jorgeregidor/Motion_Capture/Eagle/Gerber/0x69-2.brd

## EAGLE design Eagle/Gerber/0x69-2.brd (2014-03-29)

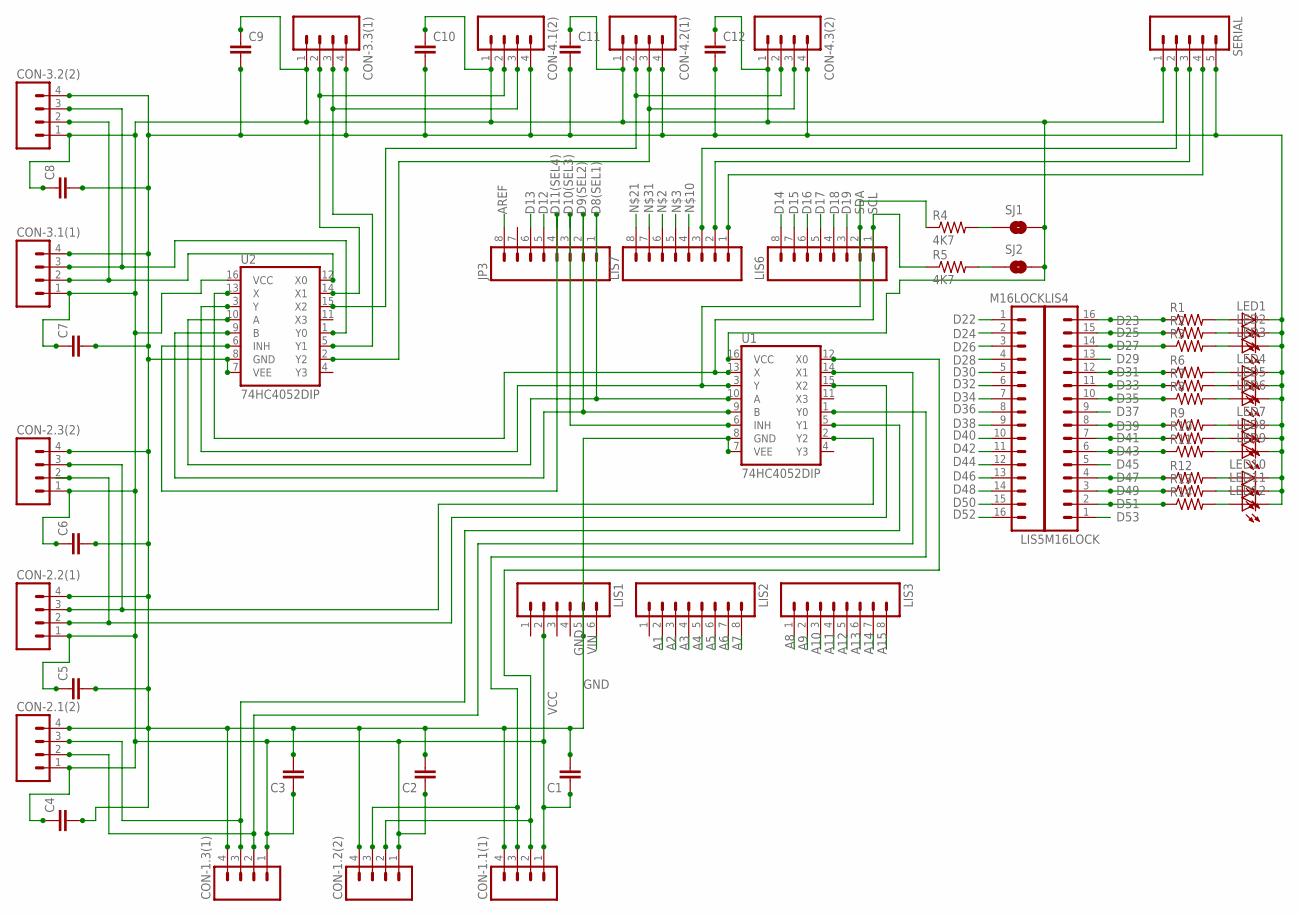
[picture p1: schematic 0x69-2.sch]

Parts:
C1, C2, C3, C4, C5, C6, C7, C8, C9, C10, C11, C12: C; C0805
CON-1.1(1), CON-1.2(2), CON-1.3(1), CON-2.1(2), CON-2.2(1), CON-2.3(2), CON-3.1(1), CON-3.2(2), CON-3.3(1), CON-4.1(2), CON-4.2(1), CON-4.3(2): M04LONGPADS; 1X04_LONGPADS
JP3: M08LOCK; 1X08_LOCK
LED1, LED2, LED3, LED4, LED5, LED6, LED7, LED8, LED9, LED10, LED11, LED12: LED-FKIT-1206; FKIT-LED-1206
LIS1: M06LOCK; 1X06_LOCK
LIS2, LIS3, LIS6, LIS7: M08LOCK; 1X08_LOCK
LIS4, LIS5: M16LOCK; 1X16_LOCK
R1, R2, R3, R6, R7, R8, R9, R10, R11, R12, R13, R14: 0.22OHM1/4W1%(0805); 0805
R4, R5: 4K7; 0603-RES
SERIAL: M05PTH_LONGPADS; 1X05_LONGPADS
SJ1, SJ2: SOLDERJUMPERNC; SJ-NC
U1, U2: 74HC4052DIP; DIL16

Connections:
A1: LIS2.2
A2: LIS2.3
A3: LIS2.4
A4: LIS2.5
A5: LIS2.6
A6: LIS2.7
A7: LIS2.8
A8: LIS3.1
A9: LIS3.2
A10: LIS3.3
A11: LIS3.4
A12: LIS3.5
A13: LIS3.6
A14: LIS3.7
A15: LIS3.8
AREF: JP3.8
D8(SEL1): JP3.1, U1.10 (A), U2.10 (A)
D9(SEL2): JP3.2, U1.9 (B), U2.9 (B)
D10(SEL3): JP3.3, U1.6 (INH)
D11(SEL4): JP3.4, U2.6 (INH)
D12: JP3.5
D13: JP3.6
D14: LIS6.8
D15: LIS6.7
D16: LIS6.6
D17: LIS6.5
D18: LIS6.4
D19: LIS6.3
D22: LIS5.1
D23: LIS4.16, R1.1
D24: LIS5.2
D25: LIS4.15, R2.1
D26: LIS5.3
D27: LIS4.14, R3.1
D28: LIS5.4
D29: LIS4.13
D30: LIS5.5
D31: LIS4.12, R6.1
D32: LIS5.6
D33: LIS4.11, R7.1
D34: LIS5.7
D35: LIS4.10, R8.1
D36: LIS5.8
D37: LIS4.9
D38: LIS5.9
D39: LIS4.8, R9.1
D40: LIS5.10
D41: LIS4.7, R10.1
D42: LIS5.11
D43: LIS4.6, R11.1
D44: LIS5.12
D45: LIS4.5
D46: LIS5.13
D47: LIS4.4, R12.1
D48: LIS5.14
D49: LIS4.3, R13.1
D50: LIS5.15
D51: LIS4.2, R14.1
D52: LIS5.16
D53: LIS4.1
GND: C1.2, C2.2, C3.2, C4.2, C5.2, C6.2, C7.2, C8.2, C9.2, C10.2, C11.2, C12.2, CON-1.1(1).4, CON-1.2(2).4, CON-1.3(1).4, CON-2.1(2).4, CON-2.2(1).4, CON-2.3(2).4, CON-3.1(1).4, CON-3.2(2).4, CON-3.3(1).4, CON-4.1(2).4, CON-4.2(1).4, CON-4.3(2).4, LED1.C, LED2.C, LED3.C, LED4.C, LED5.C, LED6.C, LED7.C, LED8.C, LED9.C, LED10.C, LED11.C, LED12.C, LIS1.5, SERIAL.5, U1.7 (VEE), U1.8 (GND), U2.7 (VEE), U2.8 (GND)
MODE: LIS7.3, SERIAL.2
unnamed: R4.2, SJ1.1
unnamed: R5.2, SJ2.1
unnamed: CON-1.1(1).2, CON-1.2(2).2, U1.12 (X0)
unnamed: CON-1.1(1).3, CON-1.2(2).3, U1.1 (Y0)
unnamed: CON-4.2(1).2, CON-4.3(2).2, U2.15 (X2)
unnamed: CON-1.3(1).2, CON-2.1(2).2, U1.14 (X1)
unnamed: CON-1.3(1).3, CON-2.1(2).3, U1.5 (Y1)
unnamed: CON-2.2(1).2, CON-2.3(2).2, U1.15 (X2)
unnamed: LED1.A, R1.2
unnamed: LED2.A, R2.2
unnamed: LED3.A, R3.2
unnamed: CON-2.2(1).3, CON-2.3(2).3, U1.2 (Y2)
unnamed: CON-4.2(1).3, CON-4.3(2).3, U2.2 (Y2)
unnamed: CON-3.1(1).3, CON-3.2(2).3, U2.1 (Y0)
unnamed: CON-3.1(1).2, CON-3.2(2).2, U2.12 (X0)
unnamed: CON-3.3(1).2, CON-4.1(2).2, U2.14 (X1)
unnamed: CON-3.3(1).3, CON-4.1(2).3, U2.5 (Y1)
unnamed: LED4.A, R6.2
unnamed: LED5.A, R7.2
unnamed: LED6.A, R8.2
unnamed: LED7.A, R9.2
unnamed: LED8.A, R10.2
unnamed: LED9.A, R11.2
unnamed: LED10.A, R12.2
unnamed: LED11.A, R13.2
unnamed: LED12.A, R14.2
RX0: LIS7.1, SERIAL.4
SCL: LIS6.1, R5.1, U1.13 (X), U2.13 (X)
SDA: LIS6.2, R4.1, U1.3 (Y), U2.3 (Y)
TX0: LIS7.2, SERIAL.3
VCC: C1.1, C2.1, C3.1, C4.1, C5.1, C6.1, C7.1, C8.1, C9.1, C10.1, C11.1, C12.1, CON-1.1(1).1, CON-1.2(2).1, CON-1.3(1).1, CON-2.1(2).1, CON-2.2(1).1, CON-2.3(2).1, CON-3.1(1).1, CON-3.2(2).1, CON-3.3(1).1, CON-4.1(2).1, CON-4.2(1).1, CON-4.3(2).1, LIS1.2, SERIAL.1, SJ1.2, SJ2.2, U1.16 (VCC), U2.16 (VCC)
VIN: LIS1.6

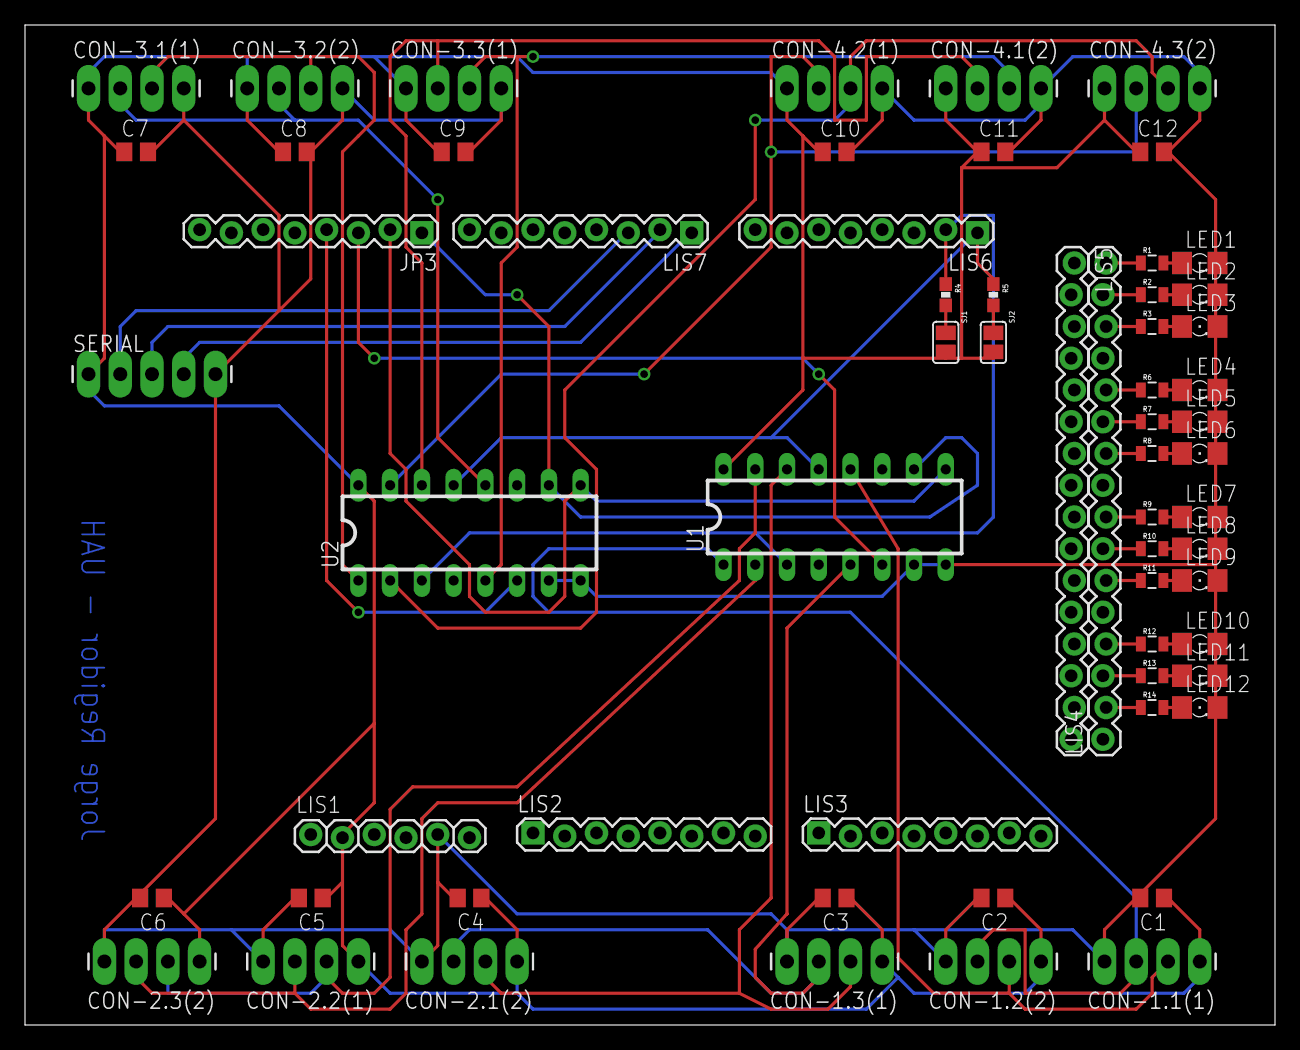
[picture p2: board 0x69-2.brd from above]

Board: 2 copper layers, 100.0 x 80.0 mm, 63 parts (0 on the bottom side), 49 nets.
